bluetiger9/Snowflake-3D-Ornament/README.md

# Snowflake-3D-Ornament

3D Snowflake Ornament with RGB Lights and BLE connectivity
