bluetiger9/Snowflake-3D-Ornament/Firmware/README.md

# Snowflake 3D Ornament / Firmware

Uses:
- Arduino IDE 2.3.x
- https://github.com/sandeepmistry/arduino-nRF5
- https://github.com/sandeepmistry/arduino-BLEPeripheral

License: MIT
