bluetiger9/Snowflake-3D-Ornament/KiCad/README.md

# Snowflake 3D Ornament / KiCad files

Uses KiCad 8.x

License: CC BY 4.0
