bluetiger9/Snowflake-3D-Ornament/3D/snowflake-assembly.FCStd

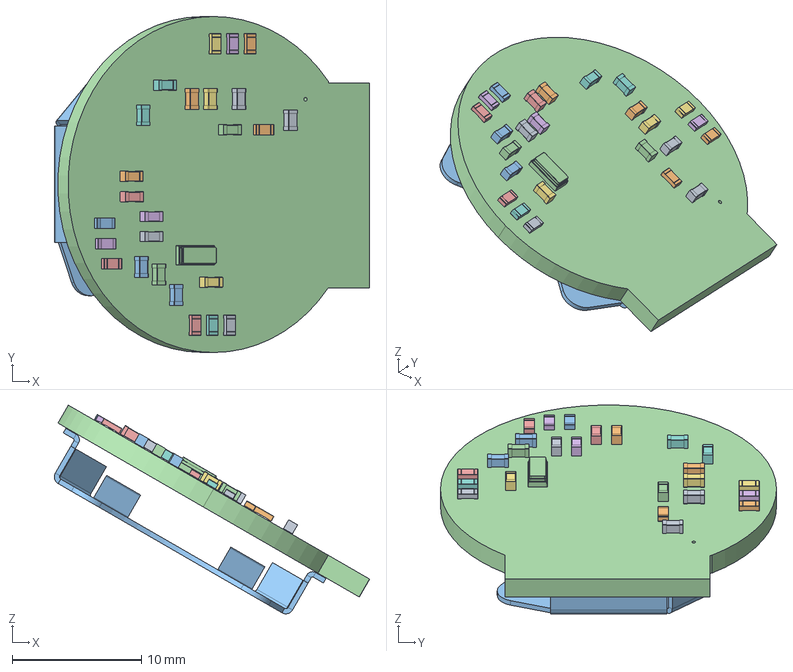
[picture p1: CAD file, 2024-12-21]
3D/snowflake-assembly.FCStd
24.4 x 26.0 x 16.2 mm
C_0603_1608Metric
C_0603_1608Metric002
C_0603_1608Metric004
L_0603_1608Metric
L_0603_1608Metric002
L_0603_1608Metric004
C_0603_1608Metric006
C_0603_1608Metric008
C_0603_1608Metric010
C_0603_1608Metric012
C_0603_1608Metric014
Crystal_SMD_3215-2Pin_3.2x1.5mm
R_0603_1608Metric
R_0603_1608Metric002
C_0603_1608Metric016
C_0603_1608Metric018
C_0603_1608Metric020
R_0603_1608Metric004
R_0603_1608Metric006
C_0603_1608Metric022
R_0603_1608Metric008
R_0603_1608Metric010
R_0603_1608Metric012
R_0603_1608Metric014
R_0603_1608Metric016
R_0603_1608Metric018
BatteryHolder_Keystone_3034_1x20mm
Snowflake-Ornament_PCB
