bluetiger9/Snowflake-3D-Ornament/3D/snowflake.FCStd

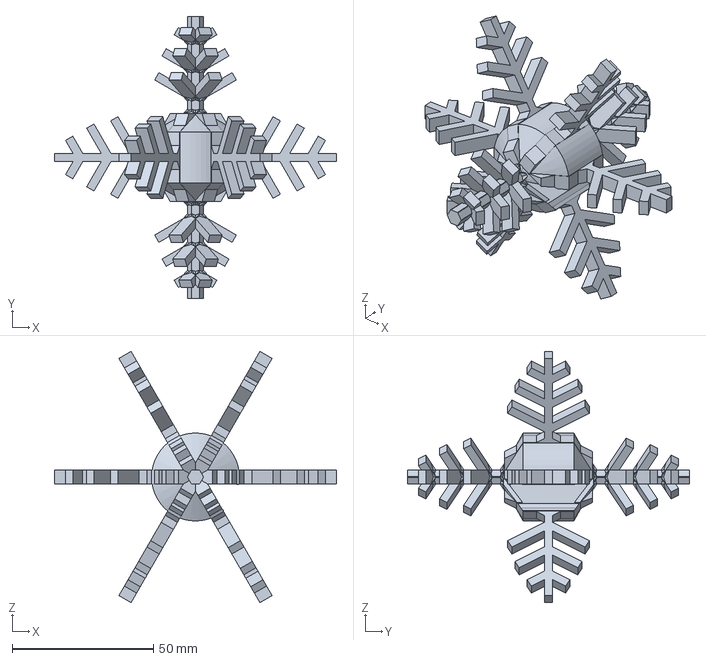
[picture p2: CAD file, 2024-12-21]
3D/snowflake.FCStd
100.0 x 100.0 x 89.1 mm
