bluetiger9/Snowflake-3D-Ornament/3D/Snowflake-Ornament.step

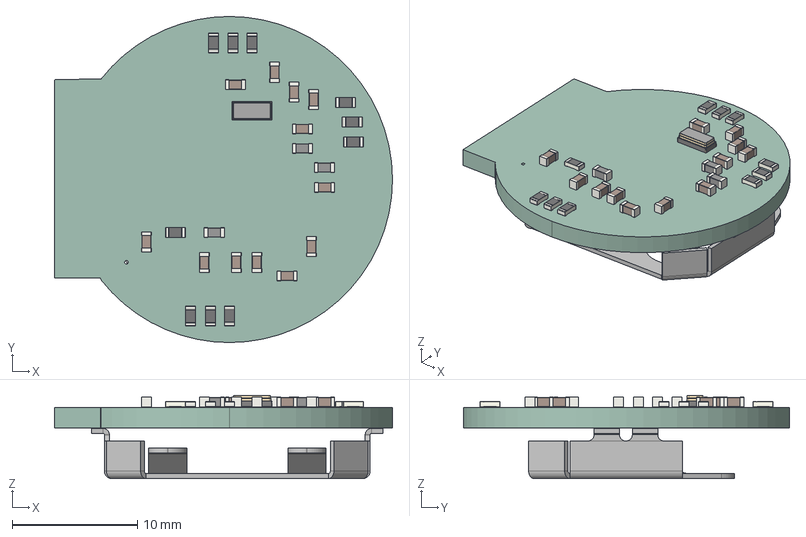
[picture p3: CAD file, 2024-12-21]
3D/Snowflake-Ornament.step
27.0 x 26.0 x 6.63 mm
C_0603_1608Metric x 12
L_0603_1608Metric x 3
Crystal_SMD_3215-2Pin_3.2x1.5mm
R_0603_1608Metric x 10
BatteryHolder_Keystone_3034_1x20mm
Snowflake-Ornament_PCB
