bluetiger9/Snowflake-3D-Ornament/(list of files, cad)

Other CAD files:
KiCad/snowflake-body.stl
