bluetiger9/Snowflake-3D-Ornament/KiCad/Snowflake-Ornament.kicad_pcb

## KiCad design KiCad/Snowflake-Ornament.kicad_pcb (2024-12-21)

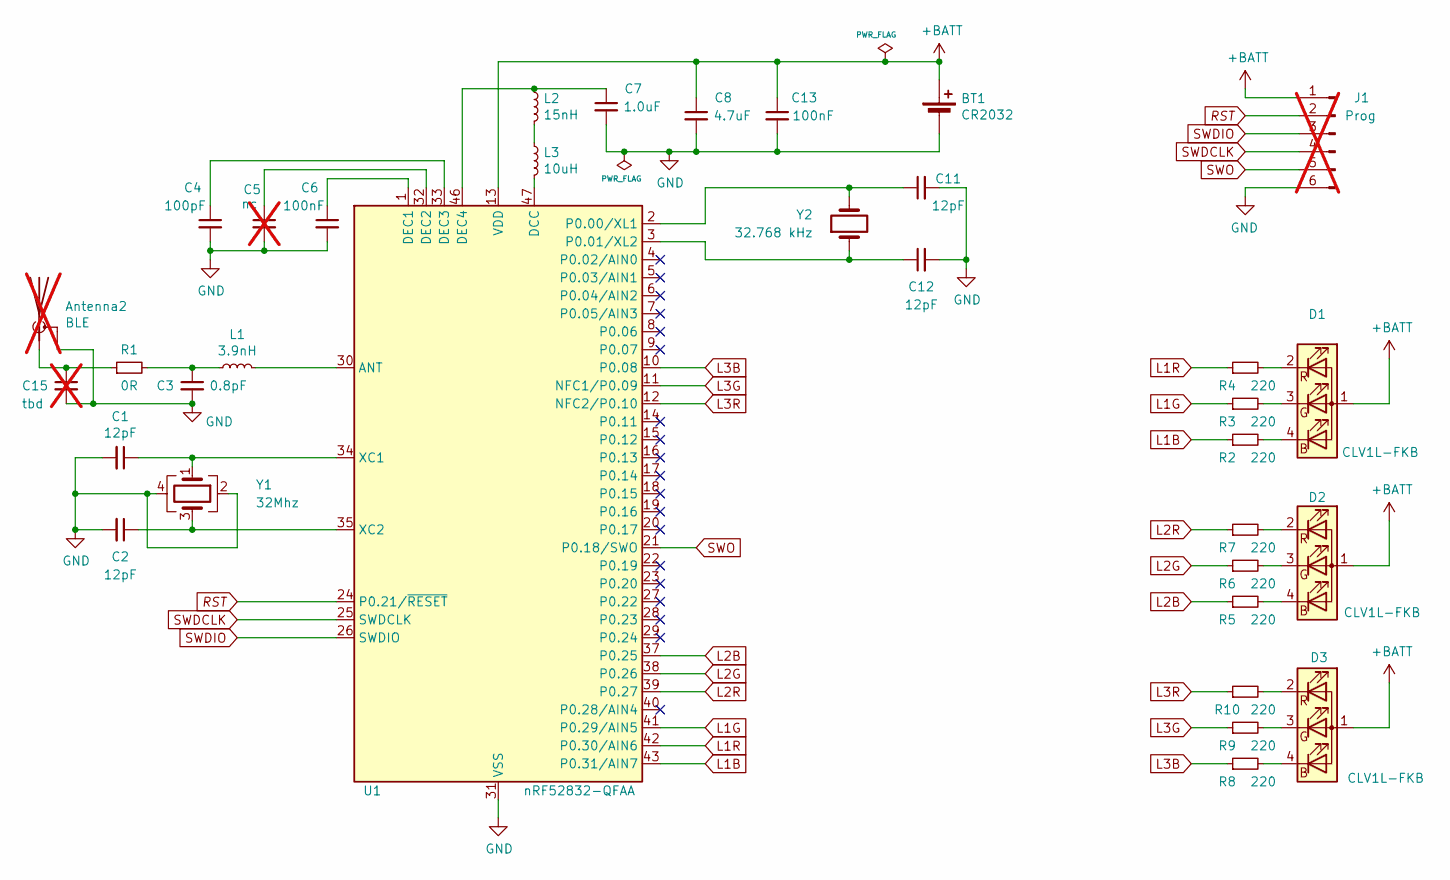
[picture p4: schematic Snowflake-Ornament.kicad_sch]

Parts:
Antenna2: BLE; Texas_SWRA117D_2.4GHz_Right; not fitted
BT1: CR2032; BatteryHolder_Keystone_3034_1x20mm
C1, C2, C11, C12: 12pF; C_0603_1608Metric
C3: 0.8pF; C_0603_1608Metric
C4: 100pF; C_0603_1608Metric
C5: nc; C_0603_1608Metric; not fitted
C6, C13: 100nF; C_0603_1608Metric
C7: 1.0uF; C_0603_1608Metric
C8: 4.7uF; C_0603_1608Metric
C15: tbd; C_0603_1608Metric; not fitted
D1, D2, D3: CLV1L-FKB; LED-CREE-CLV1L-FKB
J1: Prog; PinHeader_1x06_P2.00mm_Pad; not fitted
L1: 3.9nH; L_0603_1608Metric
L2: 15nH; L_0603_1608Metric
L3: 10uH; L_0603_1608Metric
R1: 0R; R_0603_1608Metric
R2, R3, R4, R5, R6, R7, R8, R9, R10: 220; R_0603_1608Metric
U1: nRF52832-QFAA; QFN-48-1EP_6x6mm_P0.4mm_EP4.66x4.66mm
Y1: 32Mhz; Crystal_SMD_2016-4Pin_2.0x1.6mm
Y2: 32.768 kHz; Crystal_SMD_3215-2Pin_3.2x1.5mm

Connections:
+BATT: BT1.1 (+), C8.1, C13.1, D1.1 (A), D2.1 (A), D3.1 (A), J1.1, U1.13 (VDD), U1.36 (VDD), U1.48 (VDD)
GND: Antenna2.2 (Shield), BT1.2 (-), C1.2, C2.2, C3.2, C4.2, C5.2, C6.2, C7.2, C8.2, C11.2, C12.2, C13.2, C15.2, J1.6, U1.31 (VSS), U1.45 (VSS), U1.49 (VSS), Y1.2, Y1.4
L1B: R2.1, U1.43 (P0.31/AIN7)
L1G: R3.1, U1.41 (P0.29/AIN5)
L1R: R4.1, U1.42 (P0.30/AIN6)
L2B: R5.1, U1.37 (P0.25)
L2G: R6.1, U1.38 (P0.26)
L2R: R7.1, U1.39 (P0.27)
L3B: R8.1, U1.10 (P0.08)
L3G: R9.1, U1.11 (NFC1/P0.09)
L3R: R10.1, U1.12 (NFC2/P0.10)
unnamed: Antenna2.1 (A), C15.1, R1.1
unnamed: C3.1, L1.1, R1.2
unnamed: D1.4 (BK), R2.2
unnamed: D1.3 (GK), R3.2
unnamed: D1.2 (RK), R4.2
unnamed: D2.4 (BK), R5.2
unnamed: D2.3 (GK), R6.2
unnamed: D2.2 (RK), R7.2
unnamed: D3.4 (BK), R8.2
unnamed: D3.3 (GK), R9.2
unnamed: D3.2 (RK), R10.2
unnamed: L2.2, L3.1
unnamed: L1.2, U1.30 (ANT)
unnamed: L3.2, U1.47 (DCC)
unnamed: C6.1, U1.1 (DEC1)
unnamed: C5.1, U1.32 (DEC2)
unnamed: C4.1, U1.33 (DEC3)
unnamed: C7.1, L2.1, U1.46 (DEC4)
unnamed: C11.1, U1.2 (P0.00/XL1), Y2.2
unnamed: C12.1, U1.3 (P0.01/XL2), Y2.1
unnamed: C1.1, U1.34 (XC1), Y1.1
unnamed: C2.1, U1.35 (XC2), Y1.3
RST: J1.2, U1.24 (P0.21/~RESET)
SWDCLK: J1.4, U1.25 (SWDCLK)
SWDIO: J1.3, U1.26 (SWDIO)
SWO: J1.5, U1.21 (P0.18/SWO)

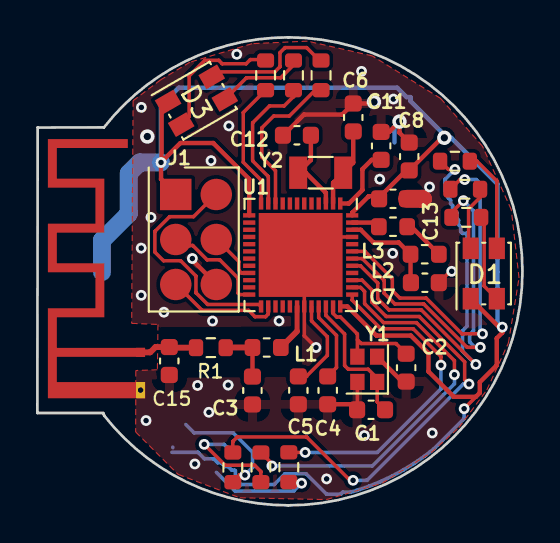
[picture p5: board Snowflake-Ornament.kicad_pcb from above]

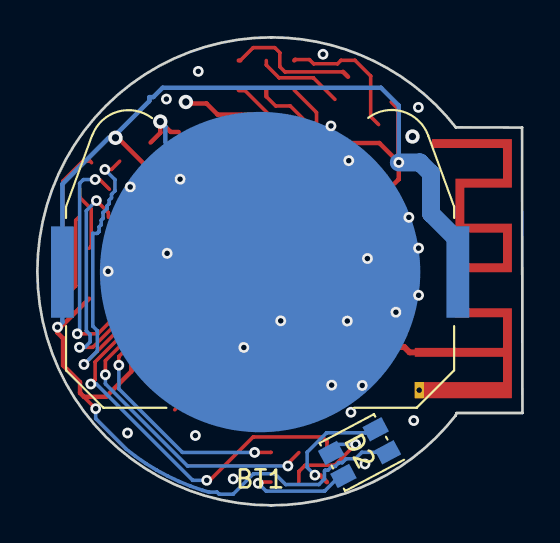
[picture p6: board Snowflake-Ornament.kicad_pcb from below]

Board: 4 copper layers, 27.0 x 26.0 mm, 34 parts (2 on the bottom side), 37 nets.
